Eliezer-Davidson/alpha-centauri/docs/evidence/chassis_pod_bolted.png

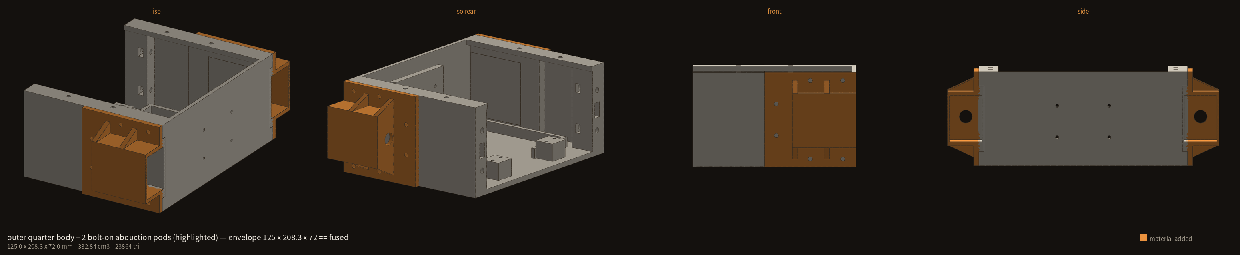
docs/evidence/chassis_pod_bolted.png
