Eliezer-Davidson/alpha-centauri/docs/evidence/chassis_pod_joint.png

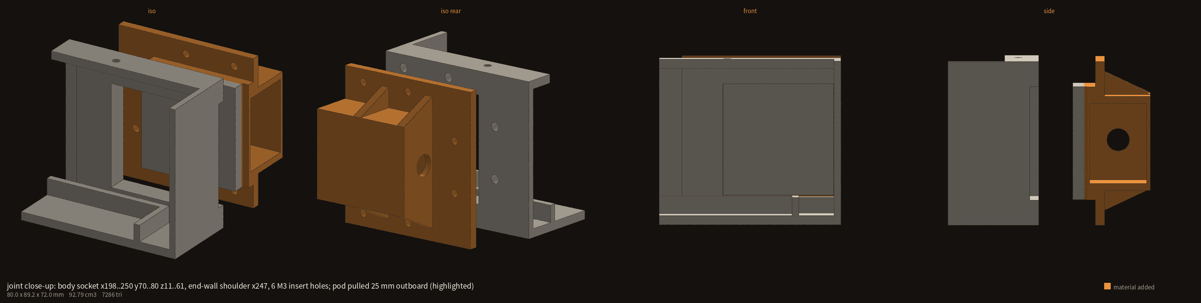
docs/evidence/chassis_pod_joint.png
