Eliezer-Davidson/alpha-centauri/docs/evidence/chassis_quarters_splice_key.png

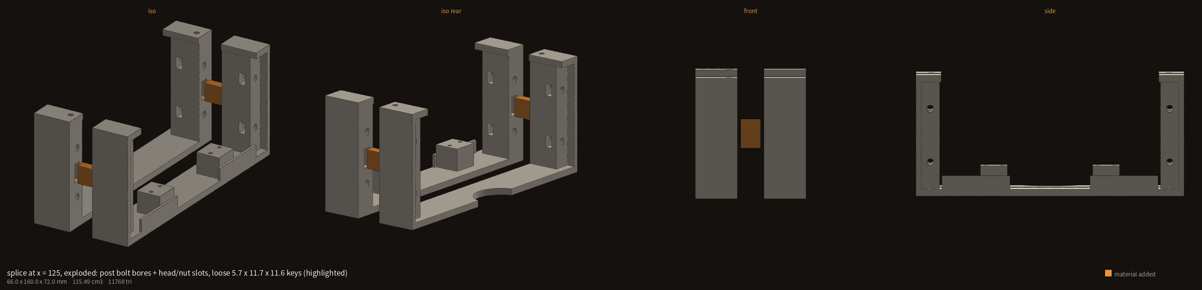
docs/evidence/chassis_quarters_splice_key.png
