Eliezer-Davidson/alpha-centauri/docs/evidence/dock_latch_engaged.png

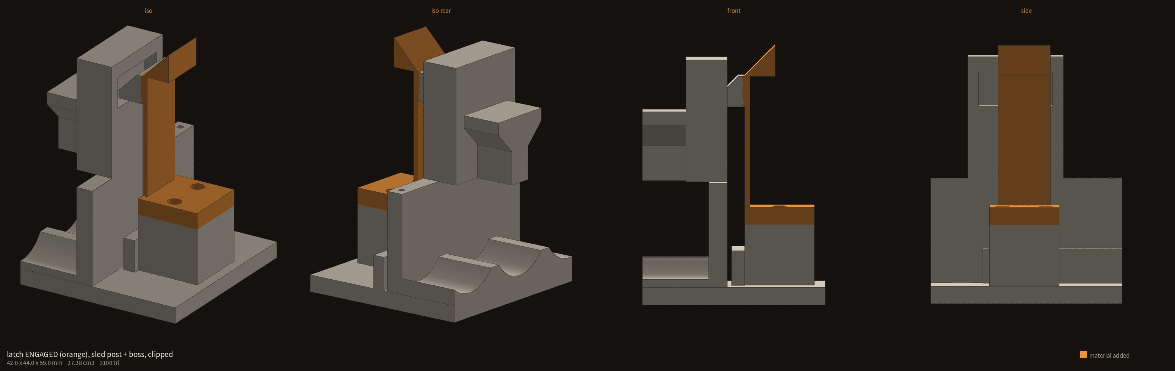
docs/evidence/dock_latch_engaged.png
