Eliezer-Davidson/alpha-centauri/docs/evidence/dock_robot_docked.png

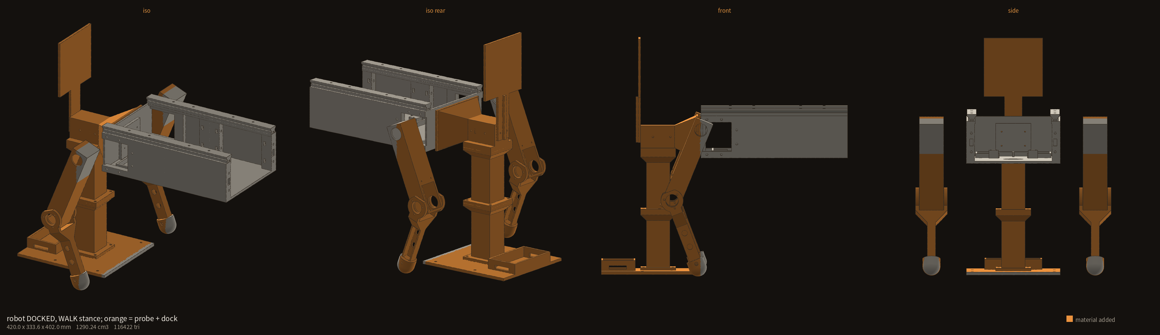
docs/evidence/dock_robot_docked.png
