Eliezer-Davidson/alpha-centauri/docs/evidence/foot_hero.png

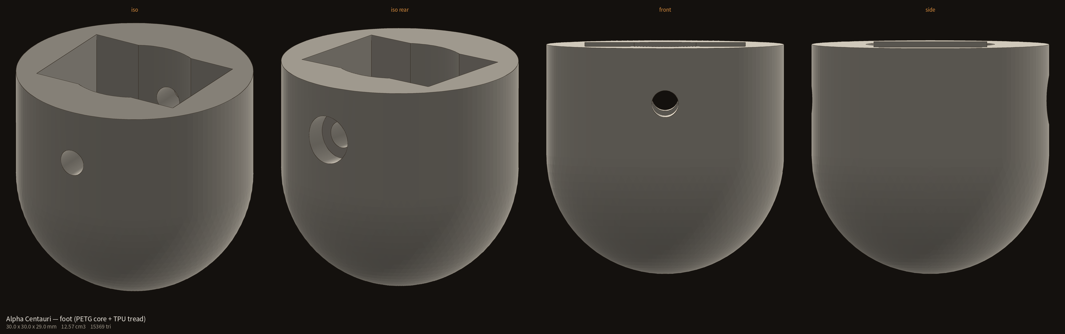
docs/evidence/foot_hero.png
