Eliezer-Davidson/alpha-centauri/docs/evidence/foot_on_calf_hero.png

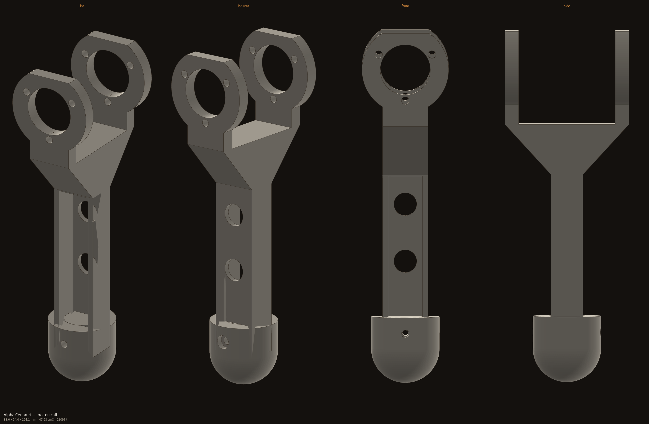
docs/evidence/foot_on_calf_hero.png
