Eliezer-Davidson/alpha-centauri/docs/evidence/foot_split_core.png

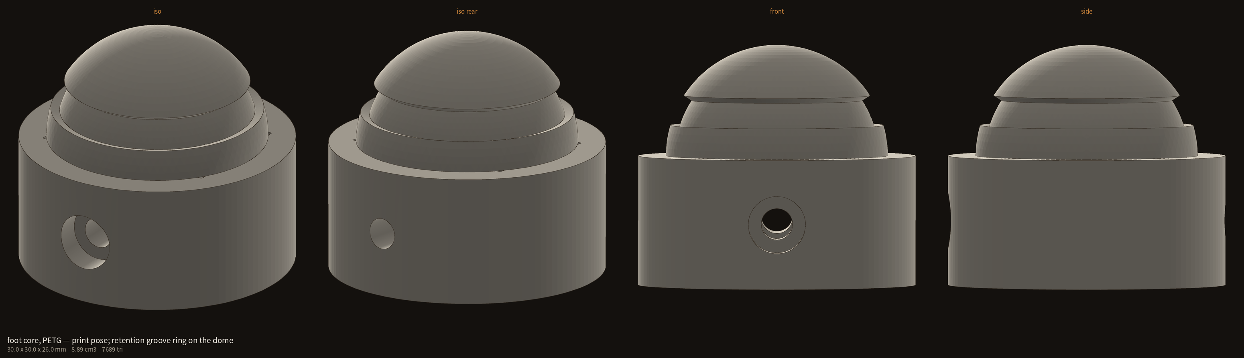
docs/evidence/foot_split_core.png
