Eliezer-Davidson/alpha-centauri/docs/evidence/foot_split_section.png

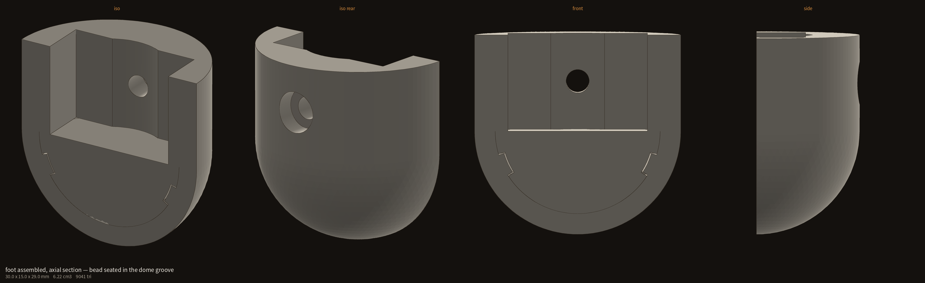
docs/evidence/foot_split_section.png
