Eliezer-Davidson/alpha-centauri/docs/evidence/foot_split_tread.png

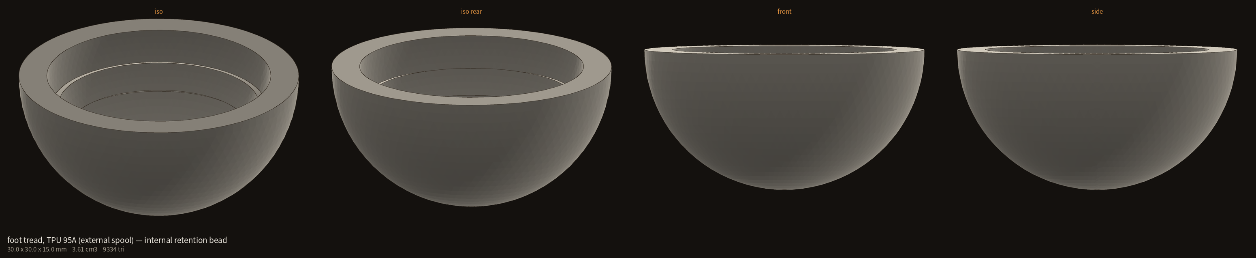
docs/evidence/foot_split_tread.png
