Eliezer-Davidson/alpha-centauri/docs/evidence/hip_leg_chain_hero.png

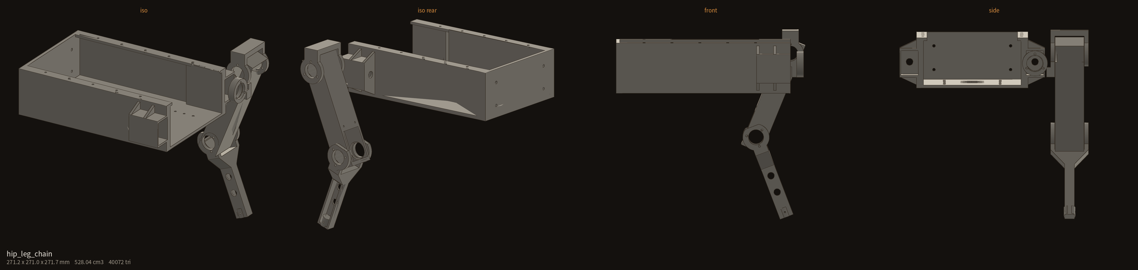
docs/evidence/hip_leg_chain_hero.png
