Eliezer-Davidson/alpha-centauri/docs/evidence/hip_module_hero.png

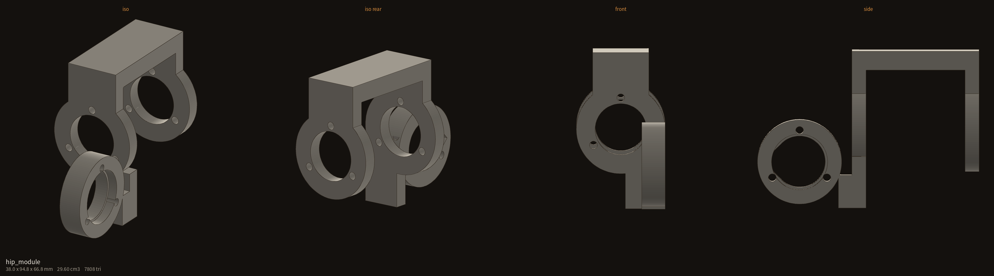
docs/evidence/hip_module_hero.png
