Eliezer-Davidson/alpha-centauri/docs/evidence/mk1_drive_closeup.png

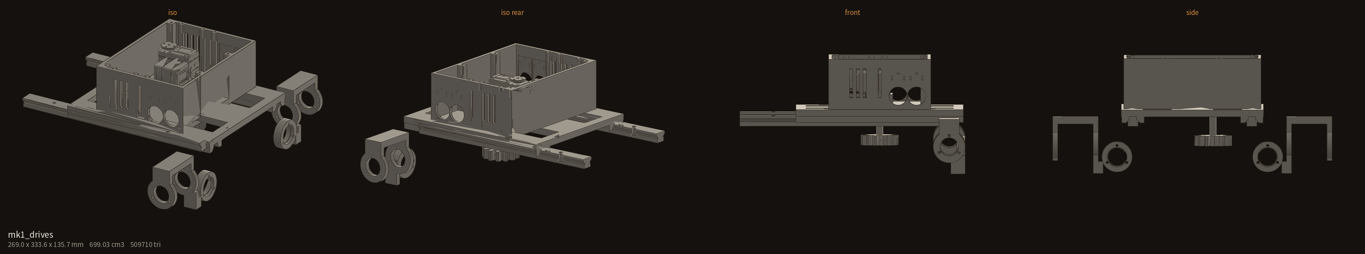
docs/evidence/mk1_drive_closeup.png
