Eliezer-Davidson/alpha-centauri/docs/evidence/mk1_work.png

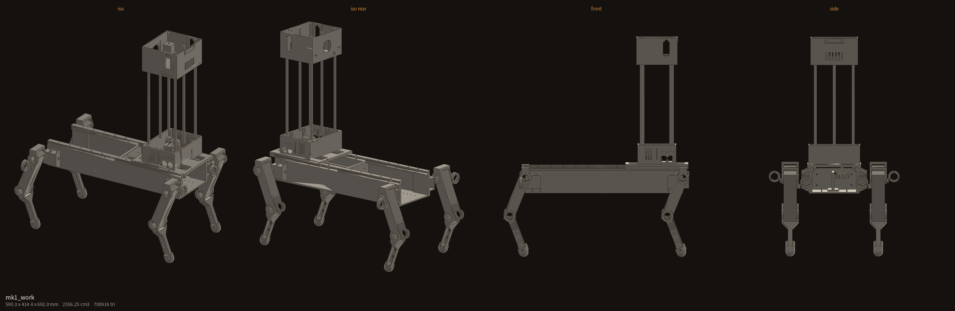
docs/evidence/mk1_work.png
