Eliezer-Davidson/alpha-centauri/docs/evidence/spine_rack_seam_engaged_hero.png

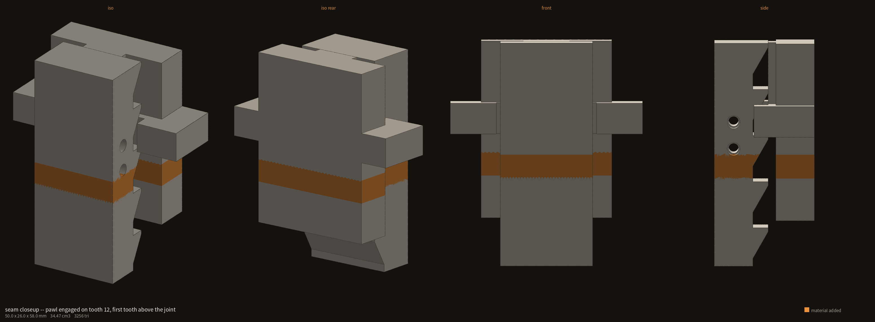
docs/evidence/spine_rack_seam_engaged_hero.png
