Eliezer-Davidson/alpha-centauri/docs/evidence/spine_rack_upper_hero.png

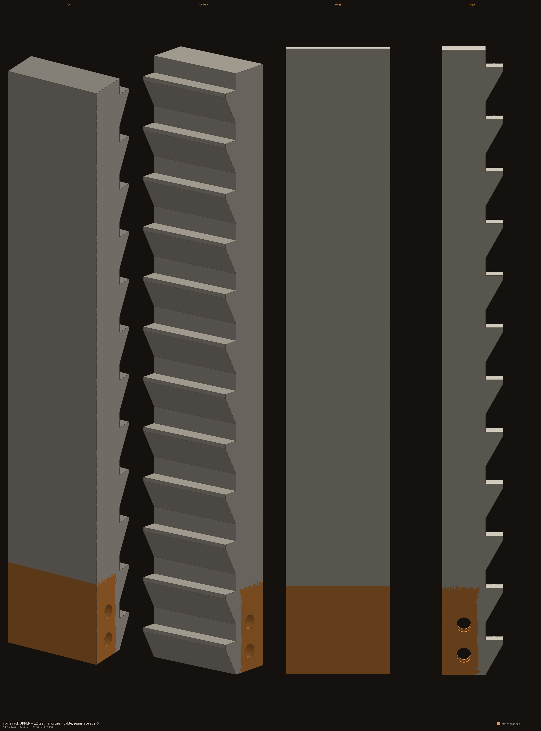
docs/evidence/spine_rack_upper_hero.png
