Eliezer-Davidson/alpha-centauri/docs/evidence/waist_rail_carriage_halves.png

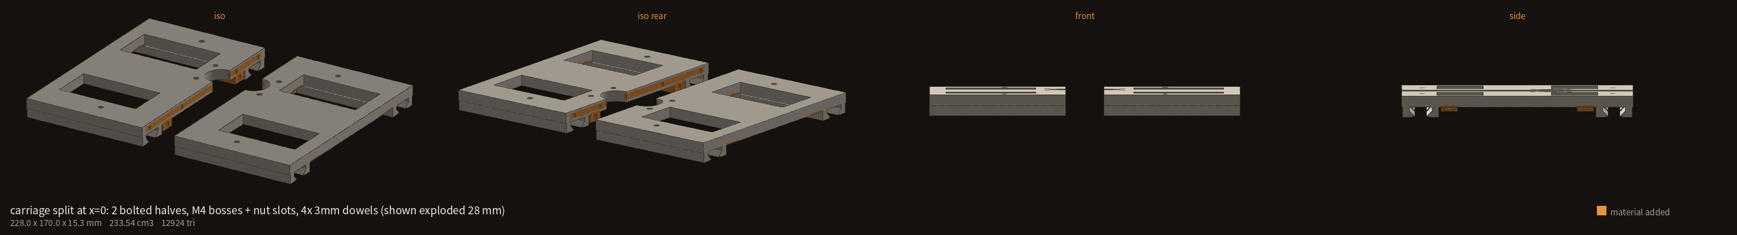
docs/evidence/waist_rail_carriage_halves.png
