Eliezer-Davidson/alpha-centauri/docs/evidence/waist_rail_joint_key.png

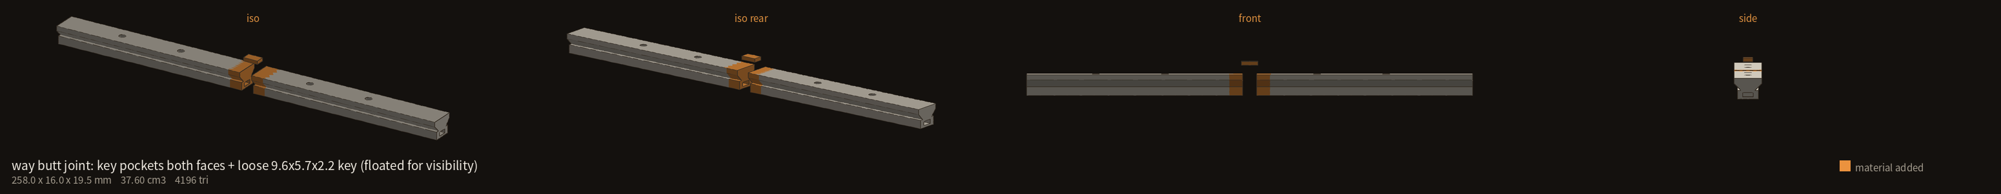
docs/evidence/waist_rail_joint_key.png
