Eliezer-Davidson/alpha-centauri/docs/evidence/waist_rail_segmented_ways.png

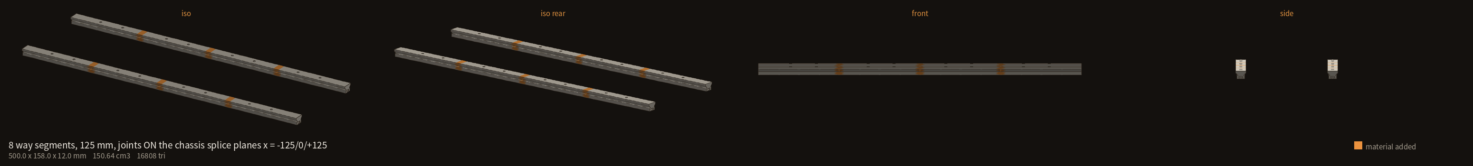
docs/evidence/waist_rail_segmented_ways.png
