Eliezer-Davidson/alpha-centauri/docs/evidence/dock_parts_print.png

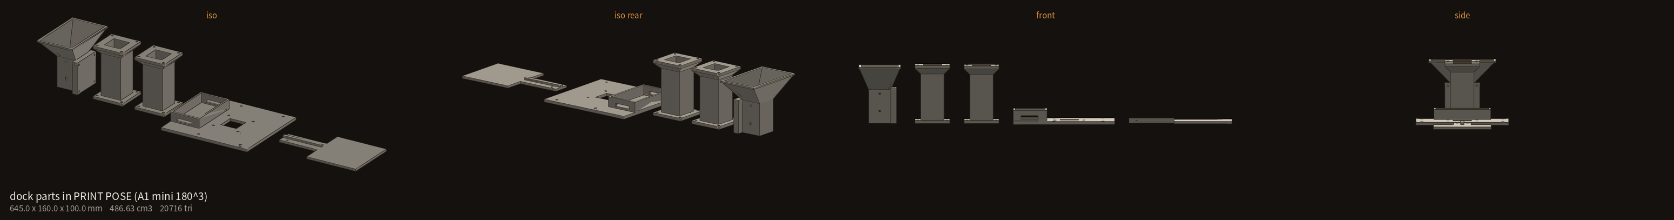
docs/evidence/dock_parts_print.png
