Eliezer-Davidson/alpha-centauri/edu/print_files_tall/RUN1/plate0_gauge/fit_gauge.stl

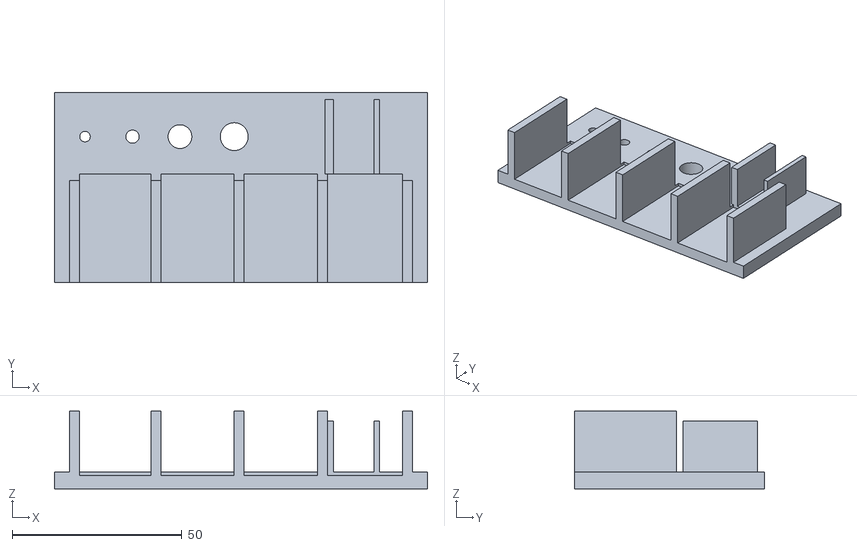
[picture p37: CAD file, 2026-10-18]
edu/print_files_tall/RUN1/plate0_gauge/fit_gauge.stl
110.0 x 56.0 x 23.0
