Eliezer-Davidson/alpha-centauri/edu/print_files_tall/step/mohawk_crest.step

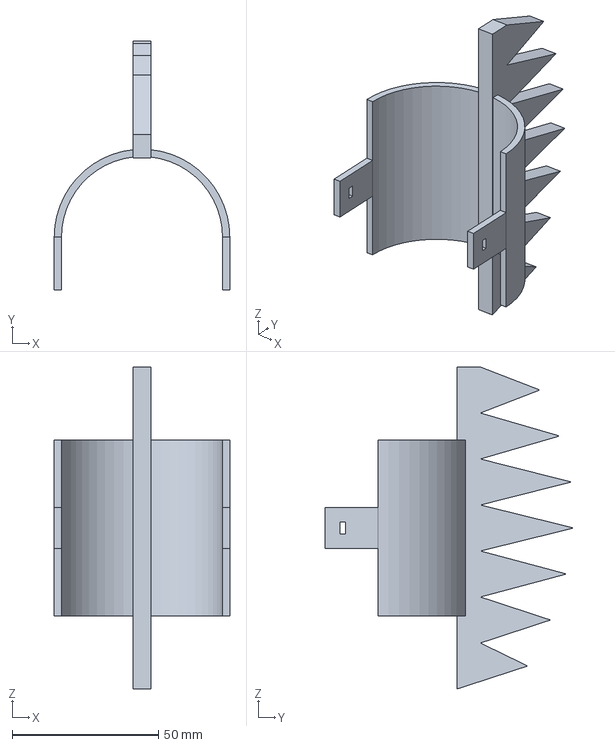
[picture p38: CAD file, 2026-10-18]
edu/print_files_tall/step/mohawk_crest.step
60.0 x 84.9 x 110.0 mm
