Eliezer-Davidson/alpha-centauri/(list of files, cad)

Other CAD files:
edu/print_files_tall/step/fit_gauge.step
edu/print_files_tall/stl/mohawk_crest.stl
