Eliezer-Davidson/alpha-centauri/docs/evidence/chassis_pod_print_pose.png

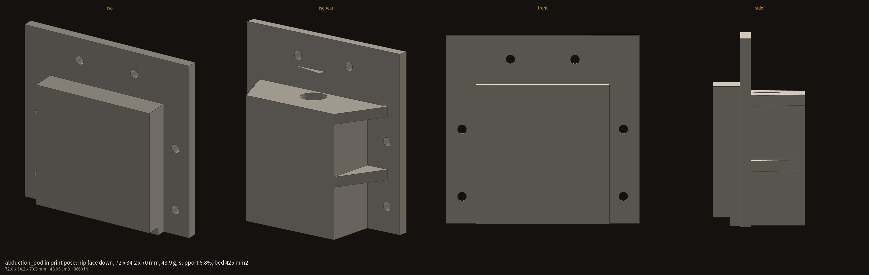
docs/evidence/chassis_pod_print_pose.png
