Eliezer-Davidson/alpha-centauri/docs/evidence/chassis_quarters_assembly.png

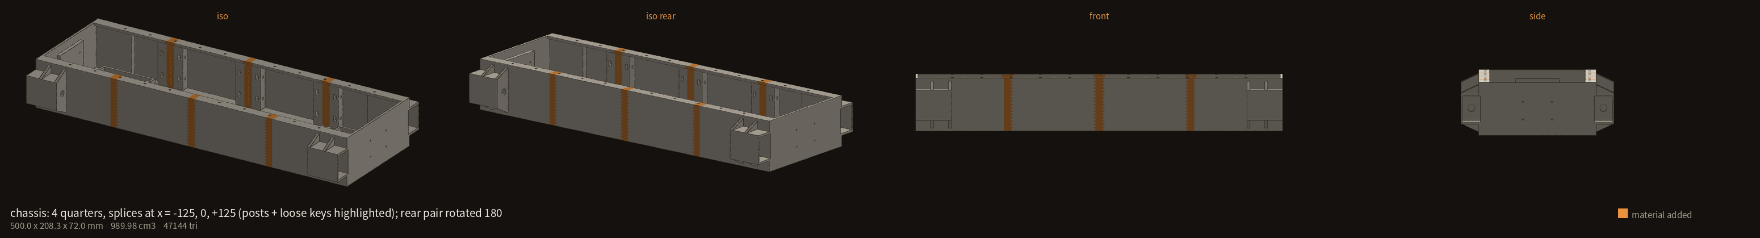
docs/evidence/chassis_quarters_assembly.png
