Eliezer-Davidson/alpha-centauri/edu/print_files_tall/renders/height_comparison.png

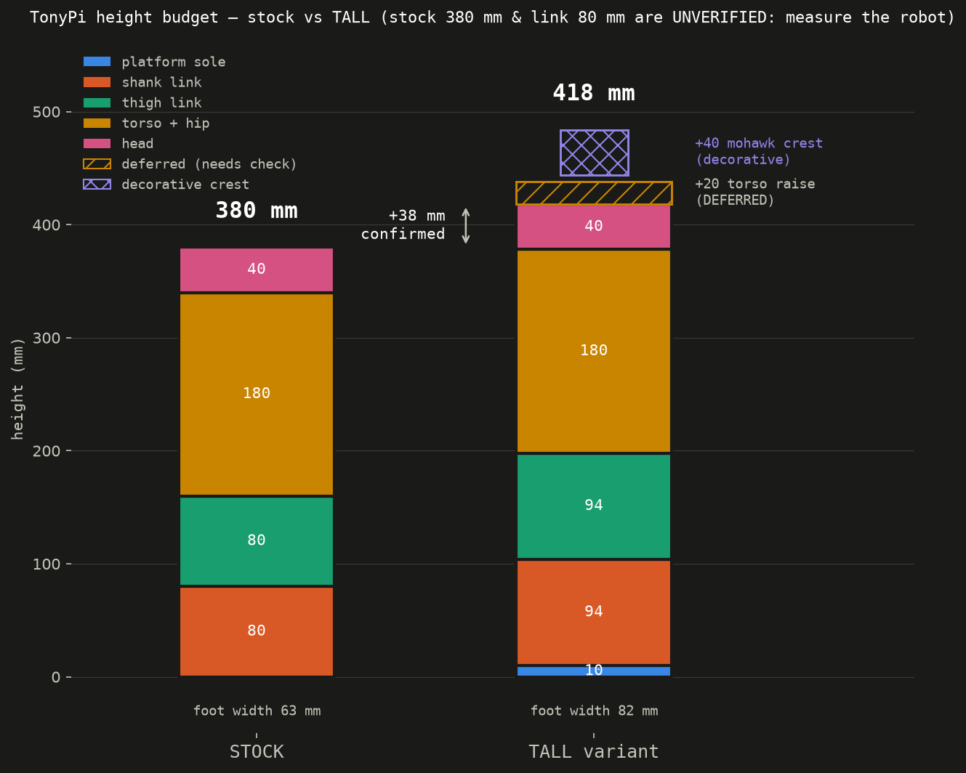
edu/print_files_tall/renders/height_comparison.png
