Eliezer-Davidson/alpha-centauri/edu/print_files_tall/renders/hero/fit_gauge_hero.png

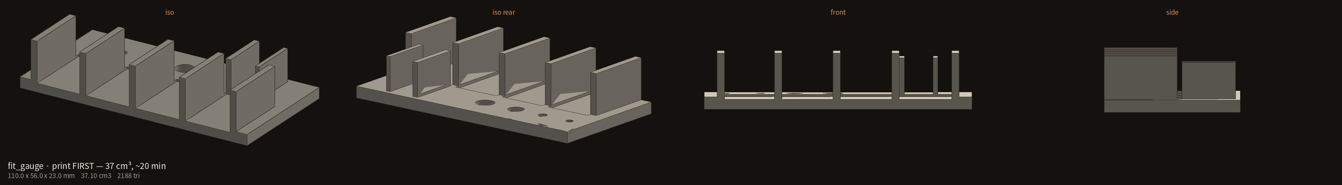
edu/print_files_tall/renders/hero/fit_gauge_hero.png
