Eliezer-Davidson/alpha-centauri/edu/print_files_tall/renders/hero/mohawk_crest_hero.png

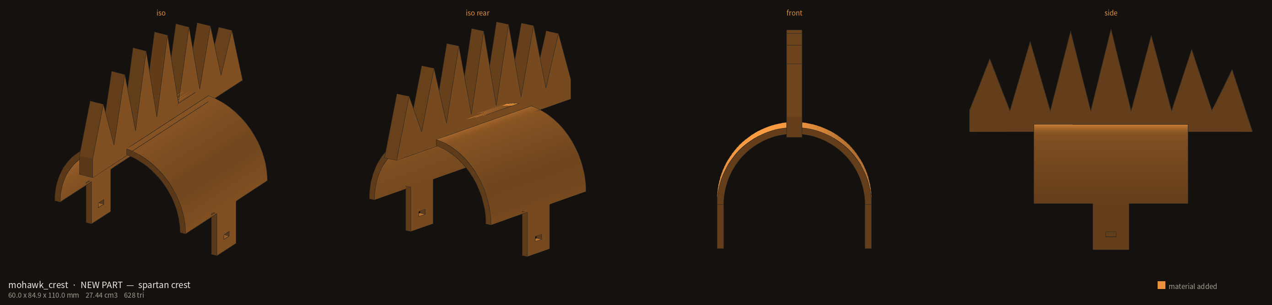
edu/print_files_tall/renders/hero/mohawk_crest_hero.png
