Eliezer-Davidson/alpha-centauri/cad/telescopebot/VERIFICATION.md

# TelescopeBot CAD — adversarial verification report (2026-07-30)

Pipeline: datasheet research -> `hardware_constants.py` (12 components, 54
UNVERIFIED constants needing calipers) -> authoring (waist_box.py, chest_box.py,
leg_linkage.py) -> three independent verification passes that re-ran every script
and measured the B-rep (wall census, boolean interference, facet-normal overhang
audit). The verdicts below are those passes'; fixes applied afterwards are marked
FIXED.

## waist_box (waist_box.py -> waist_box.stl + spine_servo_deck.stl)
**Verdict: PASS_WITH_ISSUES**

### Issues
- MAJOR: ST3215 retention screws mis-specified vs hardware_constants — code drills four 2.4 mm ('M2') floor holes up into the boss's 9.9-square pattern, but ST3215_TOP_HOLE_DIA=2.5 (M3 tap-drill, blind 2.5) and ST3215_HORN_SCREW_M=3: an M2 screw cannot engage a 2.5 mm hole and an M3 cannot pass a 2.4 mm hole. As printed the waist-yaw servo cannot be screwed down; holes should be M3_CLEAR (3.4). Field fix is drilling the 1.5 mm web, but the assumption list presents this as clean.
- MAJOR: the required width-choice statement's rationale is contradicted by the sibling part — chest_box.py (same directory, authored first) has BOX_DEPTH=130.0 > the waist's 114 mm interior depth (assumption claimed chest depth <= ~108), and the chest rod line sits at its REAR (ROD_Y=-49.5) while the waist shafts are at waist center y=0, so the aligned chest spans waist y -15.5..+114.5 and can never descend into the mouth in Y regardless of the 156 mm width. No functional impact today (chest bottoms out on the 34 mm horn-coupler tops above the rim, as the docstring itself admits), but the 'telescopes OVER the chest' story does not hold against the chest as designed.
- MAJOR: disclosed requirement deviation on hip DOF — the brief asked per-leg pitch+roll SCS15 bays at the bottom corners; all four bays have shafts along +/-X (two PARALLEL pitch-type axes per leg), roll deferred to an unbuilt external bracket, and bays moved to the FRONT corners. The rear-corner impossibility is real (verified: a side-wall SCS15 body envelope x 37.4..78 overlaps the battery envelope x +/-55.5, y -57..-16.5), but this changes the robot's DOF plan and needs the author's sign-off.
- MINOR: SCS15 idler-boss vs front lid posts — with a 12 mm boss dia (dimension ABSENT from hardware_constants; only 5.6 protrusion recorded) the inboard idler boss of both y=44 bays intersects the (+/-32, 53) lid posts by 18.9 mm^3 (~1 mm sliver); clears if boss dia <= 10 mm. Caliper the boss; if 12, nudge posts or clip a corner. Not covered by any module assert.
- MINOR: hanging spine-servo front face (y=10.03) to y=22 hip-bay recess edge (y=11.65) is only 1.63 mm; asserted positive but leaves no allowance for FS5103R case-lid screw heads/label bulge.
- MINOR: deck ligaments below the 3 mm wall rule — 2.73 mm between flange-bolt M3 hole edge and cutout end, 2.30 mm from rim-screw hole edge to deck edge (bolt-tension loaded; use washers).
- MINOR: floor web under the ST3215 boss is 1.5 mm (< WALL_MM 3.0); documented as retention-only with pocket walls taking yaw torque — acceptable draft deviation but it is a sub-minimum structural member.
- MINOR: claim inaccuracies — '10 asserts at module scope' is actually 9 module-scope + 1 in the deck function; the claimed '~4 mm annular ring bridge over the ST3215 pass-through' does not exist (that annulus is upward-facing; error in the safe direction); the near-center M2 hole is NOT fully absorbed by the horn window (10.0+1.2 > 11.0 — a 0.2 mm crescent notch survives on the window rim, cosmetic; '5 effective screws' still correct); proof PNG (16:33) predates the final STL exports (16:34) by one minute, benign since geometry is deterministic and re-verified identical.

### Author assumptions (all pending caliper verification)
- Chest box external width taken as exactly 150.0 mm (task said ~150); chest external depth assumed <= ~108 mm so it clears the 114 mm interior depth.
- Width choice (stated in docstring): waist telescopes OVER the chest -- interior width 156 = 150 + 3 mm/side so the chest descends into the open mouth. Chest-outside-waist is geometrically impossible at 120 mm rod spacing: it caps interior half-width at ~68 mm but an FS5103R body centered 10.05 mm outboard of a shaft at x=60 reaches x=70.4.
- Architectural dims not in hardware_constants: walls 4.0, floor 4.0, rim height 60.0, interior 156 x 114, outer 164 x 122 x 60.
- Spine servo deck is a SEPARATE bolt-on part (164 x 68 x 5): an integrated mid-height shelf would be a ~156 mm unsupported bridge, unprintable support-free. Deck seats on the side-wall rims; mount plane z=65; six M3 self-tappers into 12 mm rim pilots backed by full-height 4 mm internal ribs.
- FS5103R orientation: long axis along Y, shaft toward +Y, both servos identical; shaft axes at (+/-60, 0) exactly SPINE_ROD_SPACING_MM apart. Flange bolts are M3 + nut through M3_CLEAR holes at the researched 49.5 x 10.0 pattern (servo holes are 4.5 dia).
- Coupler clearance: a 32 dia x 48 tall column above each flange is open sky (28 dia x 34 coupler + margin); verified by assert, servos hang 25.9 below deck top to z=39.1, clearing battery top (34) by 5.1 mm.
- M2 clearance hole dia 2.4 (house constants only define the 1.8 pilot).
- SCS15 horn window 22.0 dia = ROUND_HORN_DIA 19.95 + 2.05 clearance.
- Hip bays deviate from 'bottom corners' deliberately: all four SCS15 bays are on the side walls, body vertical, bottom face 2 mm above the floor, shaft axes at z=16.15 pointing out +/-X, paired toward the FRONT corners (y=+22 and +44) because the 110 x 40 battery tray owns the rear floor -- a rear-corner pocket cannot coexist with it in a 156 mm interior. Per-leg roll DOF hangs off an external bracket in a later part. Bay = 0.6 mm locating recess (0.5 fit) + horn window + M2 clearance holes at the researched SCS15 top-face pattern.
- ST3215 waist yaw: pocket fit 0.5, pad walls 3.0, capture depth 12; boss recess = BOSS_DIA + 0.5 x 2.5 deep; spline/horn-hub pass-through 12.0 dia (assumed); M2 screws come up from below through 2.4 holes -- only ~1.5 mm of floor remains under the boss (retention only, pocket walls take the yaw torque).
- Battery tray: 0.5 mm clearance per side, retaining ribs 3 thick x 10 tall; interior depth was bumped 110 -> 114 specifically so the battery envelope clears the ST3215 pad (0.85 mm margin, asserted). Battery envelope itself is UNVERIFIED in hardware_constants -- caliper before printing.
- Vent slots 4 x 35 mm, four per side wall, bottom edge at z=14.
- Lid posts 8 x 8 full-height at (+/-32, +53) and (+/-74, -53) with M3 pilots 12 deep; front pair sits inboard of the hip bays.

### Verification measurements
- Re-run: exports regenerated (waist_box.stl/.step, spine_servo_deck.stl/.step, new mtimes), printed output identical to claim: waist_box 164.0 x 122.0 x 60.0 mm / 221.3 cm^3; deck 164.0 x 68.0 x 5.0 mm / 46.7 cm^3 — both far inside the 350 mm bed.
- Spine shaft spacing measured from deck cutout centers: -60.000 / +60.000 -> 120.000 mm, exactly SPINE_ROD_SPACING_MM and symmetric; deck rim-screw holes (+/-78, -40/-10/6) coincide exactly with the box rim pilots.
- Walls (BRep plane census): side walls 82-78 = 4.00; at hip recess 82-78.6 = 3.40; front/rear 61-57 = 4.00; floor 4.00; ST pad walls 25.95-22.95 = 3.00 (X) and 15.65-12.65 = 3.00 (Y); battery ribs 3.00; deck ribs 4.00; deck plate 5.00 — all >= 3 mm except the documented 1.5 mm boss web and the two deck ligaments (2.73 / 2.30 mm) flagged above.
- Pocket clearances vs hardware_constants (all positive, 0.5 total unless noted): deck flange cutouts 20.65 x 40.65 vs body 20.15 x 40.15 (+0.5); flange M3_CLEAR r=1.70 holes at exact 49.5 x 10.0 pattern (y=-34.8/14.7, x=+/-55/65); ST3215 pocket 45.9 x 25.3 vs 45.4 x 24.8 (+0.5), boss recess dia 20.5 vs 20.0 (+0.5) x 2.5 deep, ST M2 holes at exact +/-4.95 (9.9 square); hip recesses 20.7 x 40.7 vs 20.2 x 40.2 (+0.5) x 0.6 deep, horn windows r=11.00 at exact axis height z=16.15, y=22/44; battery rib faces +/-55.5 and -16.5 give +0.5/side around the 110 x 40 envelope; 10 M3_PILOT r=1.35 holes at all 6 rim + 4 post positions.
- Interference booleans (intersection volume): FS5103R hanging bodies, battery envelope, ST3215 body+boss, all four SCS15 bodies, both 32-dia x 48 coupler columns (vs box AND deck), and deck-seated-on-rim vs box ALL = 0.000 mm^3; only SCS15 12-dia idler boss vs front lid posts = 18.907 mm^3 per side at y=44.
- Derived margins: spine body |x| 70.325 vs rib face 74.0 (3.68); spine bottom z=39.10 vs battery top 34.0 (5.10, matches claimed 5.1); ST pad edge 15.65 vs battery envelope front 16.5 (0.85, matches claim); spine front y=10.025 vs hip bay edge 11.65 (1.63).
- Printability (own STL facet audit, overhang = asin(-nz) > 50 deg, bed face excluded): waist_box 5.02 cm^2 TOTAL across 36 regions but largest single region 52.6 mm^2 = 0.53 cm^2 (horn-window top arcs x4), then 8 flat 16 mm^2 vent-slot ceilings (4 mm bridges) and 12.4 mm^2 recess tops — ZERO regions > 2 cm^2; spine_servo_deck 0.00 cm^2. Both parts print support-free as exported.
- Assumption cross-checks: chest_box.py BOX_WIDTH = 150.0 exactly (waist assumption TRUE) but BOX_DEPTH = 130.0 and ROD_Y = -49.5 (waist depth assumption FALSE, see MAJOR); FS5103R 49.5/10.0/4.5/25.9/10.05, SCS15 19.95 horn + full top-face hole pattern, ST3215 45.4/24.8/20.0/2.5/9.9 all correctly transcribed from hardware_constants; M2_CLEAR=2.4 sane for true M2 hardware (hip bays OK — servo pilots are 1.6 for M2) but wrong for the ST3215 boss (M3-class); proof PNG exists and depicts both labeled parts.

## chest_box (TelescopeBot moving carriage) — `cad/telescopebot/chest_box.py` -> `output/chest_box.{stl,step}`
**Verdict: PASS_WITH_ISSUES**

### Issues
- CRITICAL (by the task's >2 cm^2 aggregate threshold; see nuance): shoulder-pad undersides at z=17 are blind 90-deg ledges — flat horizontal undersides 3.0 mm deep x 36 mm, anchored only along the wall, 1.08 cm^2 each, 2.16 cm^2 combined. Not bridges (free at both ends). No SINGLE region exceeds 2 cm^2, droop is cosmetic (pocket bottom is 12.3 mm higher, pilots 8.9 mm higher), and PETG will droop-print rather than fail — hence overall verdict PASS_WITH_ISSUES, not FAIL. Fix is one house-style 45-deg under-chamfer per pad; the author applied exactly this treatment to the RealSense strip in the same part but missed the pads.
- MINOR: RealSense screw stack is designed to exactly Intel's 3.0 mm max insertion (3.0 wall + 2.0 boss = 5.0; M3x8 -> 3.0, asserted in code). Zero margin: a wall printed 0.1-0.2 mm thin pushes insertion past spec and the screws bottom out in the camera. Add one washer per screw or verify printed wall thickness first.
- MINOR: LM2596 pilot depth is 6.0 mm (z 8.0 -> 2.0) with only 2.0 mm floor beneath; an M3x8 through the 1.6 mm board needs 6.4 mm — bottoms out 0.4 mm before seating. Use M3x6 (4.4 mm engagement). No screw length is specified anywhere for this bay.
- MINOR: hardware_constants explicitly says MG996R mounts should be DESIGNED WITH SLOTTED HOLES (4.3 x 6) due to clone spacing variance 48.0-48.6 / 10.0-10.4; the part uses round 2.7 mm self-tap pilots at exact nominal 48.30 x 10.20. Variance must be absorbed by the flange-hole slack (4.2 hole vs 3.0 screw, ~±0.6) — workable with the claimed washers, but it contradicts the constants' stated recommendation. MEASURE-BEFORE-TRUSTING caveat was correctly carried by the author.
- MINOR (documented deviation, correct call): Jetson standoffs use 2.2 mm pilots for M2.5, deviating from the original requirement's 'M3 pilots' — consistent with hardware_constants (ORIN_NANO_HOLE_DIA=2.75, 'M3 will NOT pass'). The requirement as written is physically unsatisfiable; deviation is explicit in the code comments and the author's claims.
- MINOR: web between each fan pilot and the octagon opening edge measures 2.17 mm (< WALL_MM 3.0). Non-structural and inherent to the standard 40 mm fan pattern (a round 38.2 opening gives the same 2.18 mm), but self-tapping M3 into a 2.7 pilot 2.2 mm from a free edge can split; drive gently or use M3_CLEAR + nuts (constants allow either).

### Author assumptions (all pending caliper verification)
- Box envelope 150 x 130 x 85 mm external with 4 mm floor -- architectural choices (width per task's ~150; depth sized so the Jetson mounted length-along-Y and the LM2596 bay coexist; height clears the gabled shoulder pockets)
- Rod clearance bore 8.5 mm dia -- task-specified, not present in hardware_constants.py
- Nut towers: 29 x 31 x 48 mm blocks fused into the rear wall and side walls; bore axis 14 mm from the tower inboard face; nut slot bottom at Z=20; slot ends 0.5 mm past the nut half-diagonal (M8_NUT_AF/sqrt(3)) so the nut centers on the bore
- Jetson standoff pilots are 2.2 mm for M2.5 self-tappers -- a DELIBERATE deviation from the task's 'M3 pilots': ORIN_NANO_HOLE_DIA=2.75 and the researched constants state M3 will NOT pass the devkit holes. Boss height 6.0 (ORIN_NANO_BOSS_HEIGHT_MIN+1), boss OD = official 8.0 keep-out, pattern center at X=+2 with board length along Y and the I/O edge facing -X (28 mm connector clearance to the left wall)
- RealSense D435/D435i selected (M3 rear holes at 45 mm; the D455 uses M4 and would need a constants edit): hole height Z=77 puts the camera top ~4.5 mm above the box rim for clear FOV; boss row 2 mm proud, 60 long, 12 tall, 45-deg chamfered underside; total screw stack 5.0 mm so M3x8 gives exactly the 3.0 mm max insertion (asserted in code)
- MG996R shoulder pockets: 0.5 mm clearance per side around the body; centers at (Y=30, Z=50) chosen to clear the towers, nut slots, Jetson I/O connectors, and LM2596 components; pilots M3_PILOT for M3 self-tappers + washers (constants recommend washers due to 4.0-4.3 clone hole variance); interior pads thicken the wall 3->6 mm for screw engagement; 45-deg gable roofs replace 41 mm bridges
- Fan opening is an OCTAGON (apothem = FAN40_OPENING_DIA/2 = 19.1) instead of a round hole so the vertical rear wall prints support-free (45-deg diagonals, 15.8 mm flat top bridge); fan center Z=42; wall pilots M3_PILOT
- Grommet 10 mm dia (task-given) at (X=+35, Z=12); left ROUND -- a rubber grommet needs a circular hole and a <=10 mm circular bridge in a vertical wall prints acceptably (the one knowing exception to the 50-deg overhang rule)
- Ventilation: 6 front-wall slots 4 x 25 mm at 10 mm pitch (4 mm top bridges)
- LM2596 bay center (56, 25): bosses OD 7 x 4 tall at the two diagonal corner holes (spacing from LM2596_HOLE_SPACING_DX/DY); pilots M3_PILOT for M3 self-tap through the board's 3.0 mm holes (clones vary -- caliper first per constants); rails 3 mm thick with 0.2 mm per-side clearance, ends open for wiring, trimpot faces the open top
- Modeling robustness values: 0.5 mm solid embed where added bosses meet walls/floor and 0.5 mm cutter overshoot past faces (no coincident-face booleans)

### Verification measurements
- Re-run: exports regenerated (stl+step mtime 1785408438 -> 1785409136); console '150.0 x 132.0 x 85.0 mm, volume 268.3 cm^3'; independent re-import: 1 solid, 268.25 cm^3, bbox 150.000 x 132.000 x 85.000 (Y=132 = 130 box + 2 proud RealSense boss row, as claimed)
- Bed fit: 150.0 x 132.0 x 85.0 vs 350^3 bed -> margins 200.0 / 218.0 / 265.0 mm
- Spine spacing: rod bore axes measured at X = -60.000 / +60.000 -> 120.000 mm = SPINE_ROD_SPACING_MM exactly; bore r=4.25 (dia 8.5, task-specified) vertical through tower+floor (z -0.5..48.5) -> 0.25 mm/side radial vs 8.0 rod (sane slide fit)
- Wall thickness scans (all >= 3.0 rule): side wall 3.00 (two locations), rear wall 3.00, front wall 3.00, floor 4.00, side wall+shoulder pad 6.00 (both sides), tower bore ligaments 9.74 (inboard) / 10.74 (outboard), tower depth 30.99; grommet-to-floor ligament 3.00 (exactly at minimum, not below)
- Captive nut slot: width 13.40 (X 53.30..66.70, straddling bore at 60) vs ISO M8 nut AF 13.0 -> 0.20/side; height 7.00 (z 20..27) vs ISO 4032 nut 6.8 max -> 0.20; slot end y=-41.264 -> nut-corner axial margin 0.73 mm past centered position; slot confirmed open through rear wall (air from y=-65 to -41.26); rod through nut traps translation+rotation as claimed
- Shoulder pockets: opening 21.00 (Y 19.50..40.50) x 41.3 (Z 29.34..70.65) + gable to peak ~81.15 (measured between probes 81.0/81.4) vs MG996R body 20.0 x 40.3 -> 0.50/side; pilot pattern measured 10.20 x 48.30 = MG996R_HOLE_SPACING_WIDTH/LENGTH; 8 pilots r=1.35 through 6.00 mm wall+pad
- Jetson: 4 pilots r=1.10 (dia 2.2) at spans dX=58.00 / dY=86.00 = ORIN_NANO_HOLE_SPACING_Y/X; bosses r=4.00 (OD 8.0 = keep-out max), boss top z=10 -> 6.0 above floor (>= BOSS_HEIGHT_MIN 5.0); pilot bottoms z=2.0 -> 2 mm floor left, 8.0 mm engagement; pattern center X=+2 -> I/O edge at x=-44, 28.0 mm to left wall interior (x=-72); board footprint clash-probed all air
- LM2596: bosses r=3.5 at (48.0,10.02)/(64.0,39.98) -> diagonal 16.00 x 29.96 vs constants 16.0 x 29.97 (0.01 tessellation); rails 3.0 thick, 0.2/side clearance, top z=12.00, ends open; pilots r=1.35 to z=2.0
- RealSense: 2 holes r=1.70 (dia 3.4 = M3_CLEAR) at spacing 45.00 = D435_REAR_M3_SPACING, z=77.0; strip face y=67.0 (2.0 proud), strip z 71..83, 45-deg underside chamfer verified in STL; camera top = 77+12.5 = 89.5 -> 4.5 above the 85 rim as claimed; stack 5.0 + 3.0 = 8.0 asserted in code
- Fan: octagon apothem 19.1 (opening z 23.0..61.0 sampled ~ 22.9..61.1 flat-to-flat = 38.2 = FAN40_OPENING_DIA), flats-up orientation CONFIRMED (top width ~16.0 ~ 15.8 flat + 45-deg diagonals); 4 pilots r=1.35 at 32.0 x 32.0 = FAN40_HOLE_SPACING; constants explicitly permit M3_PILOT self-taps; pilot-to-opening web 2.17 mm
- Grommet: r=5.00 (dia 10, task-specified) at (35, z=12) in rear wall; vents: 6 slots, 6 mm webs, 4 mm top bridges (z 15..40)
- Overhang audit (13,940 facets): strict >50-deg-from-vertical off-bed area 9.70 cm^2, fully attributed with zero unexplained residual: 5.23 nut-slot ceiling bridges (13.4 mm span, anchored both sides full length), 0.72 vent-top bridges (4 mm), 0.48 octagon flat bridge (15.8 mm), 0.91 horizontal hole arcs (dia 2.7-3.4, self-supporting), 0.21 grommet arc (the documented exception), 2.16 blind shoulder-pad ledges (the only true violation); 6.15 cm^2 of downward faces sit at exactly 45.0 deg (gables, octagon diagonals, strip chamfer) — at the design limit, compliant with <=50
- Clash probes all air: Jetson board corners/(-58,0,15) I/O room, LM board space, camera space above rim, servo body inboard end (50,30,50), rod line above tower (60,-49.5,60)
- Author-claim audit: bbox/volume/1-solid/STEP-export/flats-up-octagon/45-deg-only-chamfers/bridge-inventory all independently confirmed; no contradiction between the assumptions list and hardware_constants.py found; the two deliberate deviations (M2.5 pilots, octagonal fan opening) are justified by constants and print rules respectively

## leg_linkage.py (thigh_link + calf_link)
**Verdict: PASS_WITH_ISSUES**

### Issues
- MAJOR: hip disc ligament between the 10.0 dia center-clearance bore and each of the 4x M3 clearance holes (3.4 on PCD 14) measures 0.30 mm — below one 0.4 mm extrusion width, so it prints as 4 ragged slivers or merges the holes into a rosette; M3 pan heads (~5.7-6 dia) at PCD 14 also overhang the center bore by ~1 mm. Both PCD and hub-clear are ASSUMED values, so fix when the real SCS15 horn is measured (larger PCD or smaller hub clearance) and use washers regardless.
- MAJOR: pilot-boss ligaments in load paths violate the >= 3 mm structural-wall rule: thigh M4 pilot -> lightening/wire notch 2.21 mm (all 4 pilots), rear pilot -> DS cavity 2.61 mm, front pilot -> DS cavity 2.81 mm; calf MG996R pilot -> servo cavity 2.02 mm (rear) / 2.32 mm (front). Self-tapping expansion thins these further; these columns carry the knee-servo and ankle-servo reactions. Narrowing NOTCH_HALF_W and shrinking the block-to-cavity trim margins would recover >= 3 mm without moving the fixed hole patterns.
- MINOR: thigh horizontal tendon posts — the 45-deg under-wedge does not remove the cylinder's own >50-deg under-band; measured 0.32 cm^2 of flagged area per post (clusters 20.2 + 6.6 + 5.1 mm^2, up to 90 deg). Wedge-backed at tangency so sag is bounded and area is far under 2 cm^2, but it is not strictly support-free geometry; a teardrop post profile would be. The wedge/post tangency also creates 4 four-facet seam edges in the STL (valid solid, slicer-safe).
- MINOR: calf total off-bed >50-deg overhang is 1.99 cm^2 — passes the 2 cm^2 bar by 0.014 cm^2. Largest contributors: the two lug round tips resting tangent on the bed (37.4 mm^2 each, max 77 deg, 'wheel on bed' geometry that prints rough in the first mm) and nine small horizontal-hole ceilings (11.9-16.2 mm^2 each, dia 2.7-3.4 — self-supporting at this size in practice).
- MINOR: MG996R mounting contradicts hardware_constants.py's own guidance 'DESIGN WITH SLOTTED HOLES (4.3 x 6 slots) and M3/M4 screws with washers' — fixed round 2.7 self-tap pilots at the nominal 48.3 x 10.2 centers were used instead; clone spread (48.0-48.6 x 10.0-10.4) can misplace pilots by +/-0.3 mm. Mitigated by the prominent caliper-before-printing warnings, but it is a real assumption-vs-constants contradiction.
- MINOR: documented spec deviations — task asked 'M3/M4 clearance holes per its flange' for the DS5160; author substituted M4 self-tap pilots (justification checks out: nuts cannot be loaded under 39-mm-deep columns, and DS5160_HOLE_DIA 5.5 passes M4). Calf tendon posts claimed 'near ankle': x=104.5 is, but x=55 is mid-calf (35 mm from the ankle axis), placed there to anchor on the flange block.
- MINOR: hardware_constants.py is internally inconsistent by 0.2 mm for the DS5160 (body 65.0 + 2 x 5.1 hole-beyond-face = 75.2 != 75.0 hole span); absorbed by the 0.5 mm pocket clearance, but it is unresolvable until calipered. Also the claimed 'MG996R pocket 0.25 mm per side across the body width' is only literally true of the floor strips at z=4.75; the pocket top is open and most of the under-servo floor is the 4.0 web (1.0 mm clearance) — imprecise wording, harmless geometry.

### Author assumptions (all pending caliper verification)
- DS5160 flange fastening: M4 self-tappers into 3.6 mm pilots (M4 pilot extrapolated as 0.9*d from the house M2/M3 pilot rule), 12 mm deep. The brief specified 'M3/M4 clearance holes per its flange'; true clearance holes would need nuts under 39 mm deep columns, which cannot be loaded or printed support-free, so self-tap was chosen -- the DS5160's own 5.5 mm flange holes pass M4 hardware. Sweep M4_PILOT to 4.5 if bolts+heat-sets are preferred.
- Servo pocket clearance 0.5 mm per side (mirrors FS5103R_POCKET_CLEARANCE; DS5160/MG996R have no pocket-clearance constant of their own). MG996R pocket uses 0.25 mm per side across the body width.
- Hip interface: SCS15/SC15 round horn screw pattern ASSUMED 4x M3 on 14.0 mm PCD with 10.0 mm center hub clearance -- only SCS15_ROUND_HORN_DIA (19.95) is researched. MEASURE the shipped horn before printing.
- Knee horn: DS5160 round horn ASSUMED 4x M3 on 17.0 mm PCD with 10.0 mm center clearance; horn stack height taken from DS5160_OVERALL_HEIGHT_WITH_HORN (56.8, itself flagged UNVERIFIED in hardware_constants). MEASURE the shipped horn.
- Idler pivot (a documented design call; the brief allowed M3 or a bearing): M3 x 12 screw + washer, self-tapped into a 2.7 mm pilot through the thigh web + a 12 mm dia boss (7.5 mm engagement, boss top 0.5 mm below the servo body); calf inboard lug gets an M3_CLEAR (3.4) hole; 0.5 mm running washer gap is built into the clevis span. Upgrade path: bore the lug to 8.0 and press a 693ZZ bearing.
- Gravity posts: 6 dia x 8 long with a 4.4 dia x 1.6 retention groove. Thigh posts are horizontal in print orientation and carry a full-length 45-deg under-wedge (the allowed chamfer/under-cone); calf posts are vertical with a 45-deg under-cone below the tip flange. Post positions: thigh x=18/28 near hip on the front wall; calf x=55/104.5 on the front face over the ankle flange blocks.
- MG996R ankle mount: M3 self-tappers into 2.7 mm pilots at the nominal 48.3 x 10.2 hole centers; flange bears flat on the outboard face (no recess). Constants are flagged clone-variant -- caliper the shipped servo.
- Architectural dims (module constants, sweepable): web and walls 4.0 mm (>= WALL_MM 3.0), hip disc dia 34 x 6 thick, knee-end outline radius 26 concentric with the knee axis giving a constant 3 mm crossbar running gap and roughly +/-85 deg knee ROM from straight, 4 mm air gap under the DS5160 body, calf depth 30, calf beam width 34, clevis lug thickness 5, DS5160 pilot columns lightened by 9 mm wide full-height notches (the rear one doubles as the servo wire drop-in channel).
- Handedness: the exported pair is ONE leg; print the mirror-image set (slicer mirror) for the other leg, as noted in the docstring.

### Verification measurements
- Re-run: exports regenerate deterministically — thigh_link.stl md5 f8b7c9b0..., calf_link.stl md5 0609df10... identical before/after; STEP twins present; script output matches claims exactly
- Bounding boxes vs 350 mm bed: thigh 133.00 x 53.80 x 39.00 mm (91.3 cm^3), calf 129.00 x 75.30 x 38.00 mm (55.9 cm^3), both z-min = 0 (print orientation, bed at Z=0)
- Walls (probe-measured, rule >= 3.0): thigh web 4.000, thigh side walls 4.000/4.000 (x=10), knee-block walls 5.350 (cavity start) and 8.500 (x=70), hip plate 6.000; calf web 4.000, MG floor strip 4.750, -Y beam wall 4.000, clevis lugs 5.000 each (10.000 total at x=-9), crossbar 4.000
- DS5160 pocket: cavity faces at x=37.30/103.30 -> length 66.00 = body 65.0 + 0.5/side; width 31.00 = body 30.0 + 0.5/side; tab ledge height 39.00 = web 4 + gap 4 + TAB_UNDERSIDE 31.0; pilot pattern 75.0 x 17.0 exact; pilots 12.0 deep (material stops at z=27.00); M4 pilot 3.6 = 0.9*d house rule
- MG996R pocket: cavity faces at x=59.20/100.50 -> 41.30 = body 40.3 + 0.5/side; floor at z=4.75 -> 0.25 body-width clearance; flange seat: body bottom -9.7 vs floor -10.2 -> 0.5 clearance; pilot pattern 48.30 x 10.20 exact, blind bores y 8.5..18 (8.5 mm engagement, 0.5 mm shy of through)
- Knee axis both-sides support: clevis inner span 65.30 = DS horn top 64.80 (8.0 + OVERALL_HEIGHT_WITH_HORN 56.8) + 0.5 washer gap; lug faces at +/-32.65 and +/-37.65 confirmed; idler boss top z=7.5 with 0.5 mm air to DS body bottom z=8.0; M3 pilot (2.7) through web+boss = 7.5 mm engagement; all horn/idler/teardrop voids probe-confirmed present
- Ligaments (probe-measured): hip disc center-bore -> M3 hole 0.303 mm (x4); thigh M4 pilot -> notch 2.208 mm, -> cavity 2.608/2.808 mm; calf MG pilot -> cavity 2.020/2.320 mm; calf knee-horn hole -> hub-clear 1.80 mm (analytic, on the 5 mm lug)
- Overhang audit (>50 deg from vertical, off-bed, facet-normal integration): thigh 63.9 mm^2 total (6 clusters, all at the 2 horizontal posts, largest 20.2 mm^2); calf 198.6 mm^2 total (11 clusters: lug bed-tangent bands 37.4 mm^2 x2 at max 77 deg, hole ceilings 11.9-16.2 mm^2 x9 at 90 deg); largest single cluster 0.37 cm^2 -> nothing exceeds the 2 cm^2 needs-supports bar; 44-50 deg context bands: 144.5 / 122.8 mm^2 (the 45-deg wedges and teardrop roofs land here, as designed)
- Mesh integrity: calf 0 non-manifold edges of 13746; thigh 4 non-manifold (4-facet) edges of 14588 — all at the wedge/post tangency lines z=11.0 at posts x=18/28, a tangent-seam artifact, not a defect
- Architecture: hip->knee 90.0 and knee->ankle 90.0 as required (module constants); hip disc 34.0 dia covers the 19.95 SCS15 horn; crossbar gap CB_X0 29 = KNEE_TIP_R 26 + 3.0 running clearance; calf posts anchored on solid columns 0..38 (z-scan voids at z~9-11/19-21.5 are the expected cross-drilled MG pilot bores 10+ mm below the post bases); post spec 6.0 dia x 8.0 with 4.4 x 1.6 groove on both links; SPINE_ROD_SPACING_MM 120.0 not applicable (no spine features in leg parts)

## Post-verification fixes applied
- waist_box.py: ST3215 boss retention holes 2.4 mm -> M3_CLEAR (3.4 mm). The boss holes are
  M3-class (ST3215_TOP_HOLE_DIA=2.5 tap, ST3215_HORN_SCREW_M=3); as authored the waist-yaw
  servo could not be screwed down. Regenerated + asserts pass. FIXED.

## Open design decisions (awaiting the author's decision)
1. Chest/waist telescope geometry contradiction: chest BOX_DEPTH=130 > waist interior depth 114,
   and the chest rod line is at its rear while waist shafts are centered — the chest cannot
   descend into the waist mouth as the waist docstring assumes. Options: (a) accept chest riding
   above the rim (works today, loses nested stroke), (b) shrink chest depth <= ~108 and move its
   rod towers to mid-depth, (c) deepen the waist. One shared INTERFACE constants block should pin this.
2. Hip DOF plan: waist authoring gave each leg two PARALLEL pitch-type SCS15 axes (roll deferred to
   an unbuilt bracket) and moved bays to the FRONT corners (rear is geometrically impossible against
   the battery bay). Sign off or redesign before printing the waist.
3. MG996R mounts (chest shoulders + calf ankle) use fixed round pilots at nominal spacing despite the
   constants recommending slotted holes for clone variance — decide after calipering the actual servos.
