Eliezer-Davidson/alpha-centauri/cad/alpha_centauri/foot.py

"""Alpha Centauri — foot: PETG core + SEPARATE TPU tread. Four identical pairs.

    edu/.cadenv/bin/python cad/alpha_centauri/foot.py

THE CONTRACT THIS PART EXISTS TO KEEP
-------------------------------------
The foot presents a SPHERE of radius FOOT_SPHERE_R = 15 whose centre sits ON
the calf axis at FOOT_CENTRE_FROM_KNEE = L3 - R from the knee. The OUTER
surface of the TPU tread IS that sphere. Not "about", not "plus a pad": if the
tread added thickness outside R15 the contact point would drop below the IK's
ground plane and silently change the stance -- the same class of bug (sphere
centred AT the foot instead of ON the axis) already put the drawn robot at the
forbidden 250 mm stance once. So:

    PETG core outer radius = R15 - TREAD_T   (12.0, ground side)
    TPU tread outer radius = exactly R15, SAME centre

and the build asserts both on the finished solids: every tread vertex sits in
the 12..15 shell with the outer surface exactly at 15 (the one deliberate
exception, the retention bead, is confined and asserted -- see RETENTION
below), every core vertex on the ground side of the centre sits inside 12,
and the assembled contact radius stays 15.000 at every tilt in the swept
swing check below.

WHY THE TREAD IS A FULL HEMISPHERE ENDING ON THE COLLAR RIM
-----------------------------------------------------------
Required angular coverage is DERIVED, not guessed: the calf tilts up to
~37.9 deg from vertical across the working envelope (the ~38.5 deg swing the
constants comment records -- reproduced here from the leg geometry, see
calf_tilt_deg), plus the angular half-width of the squished contact patch,
plus margin -- about 54 deg. A cap of exactly that size was drawn first and
rejected for its EDGE: any free-floating tread edge is either a >45 deg
overhung ring (radial cut), a knife-edge TPU taper (chamfered cut), or a ring
bridging over air (horizontal cut). Making the clamp collar diameter EQUAL to
the sphere (COLLAR_D = 2*R15 = 30) dissolves the problem: the tread runs all
the way to the equator and its termination ring lands flat ON the collar's
own rim, supported by PETG, with zero overhang. The silhouette is a cylinder
blending into its own ball, and coverage is 90 deg against the ~54 needed.

The PETG collar rim circle lies exactly ON the R15 sphere at the equator --
which is fine, and checked: at the maximum swept tilt it still clears the
ground (gate 4 measures the number), and the sweep assert below keeps it
that way forever.

SPLIT FOR THE A1 MINI (2026-09-07, REPLAN-2026-08-28 items 1 & 5)
-----------------------------------------------------------------
This file originally CO-PRINTED the two bodies -- TPU deposited onto the PETG
dome mid-print by the H2C's second nozzle. The H2C is gone; the only printer
is a Bambu A1 mini with ONE nozzle, so the co-print object no longer exists
on any machine this project owns. The tread is now a SEPARATE TPU part that
snaps onto the finished core. Everything the co-print design got right (the
contract, the hemisphere-to-rim termination, the clamp) is unchanged;
what is new is mechanical retention plus an assembly law:

    ASSEMBLY LAW: the tread is retained by the circumferential bead/groove
    engagement below AND a flexible adhesive of the Shoe-Goo class wetting
    the 905 mm2 spherical interface + 254 mm2 rim ring. NEVER glue alone --
    an adhesive-only joint on a flexing TPU shell fails by peel at the rim,
    exactly the load the bead exists to anchor. (Wet assembly is also the
    lubricant that makes the snap easy.)

RETENTION -- INTERNAL BEAD INTO A DOME GROOVE (the DECISION)
------------------------------------------------------------
The tread carries an internal circumferential BEAD: a spherical-band ridge
BEAD_H = 0.8 mm proud of its R12 bore, spanning polar angle 58..73 deg from
the ground pole. The core's dome carries the matching circumferential GROOVE,
cut 57..74 deg (1 deg polar play per side, ~0.2 mm) with its floor at
R11.0 -- 0.2 mm BELOW the bead crest, deliberately: the tread's radial seat
must always be the R12 dome-on-bore contact, never the bead bottoming in a
shallow groove, because a bead that props the shell outward moves the outer
surface past R15 and silently violates the contract. The groove is cut
deeper than the bead can reach; adhesive fills the void.

Rejected alternatives, recorded so they are not redrawn:
  * TPU skirt over the collar with a bead into a collar-OD groove: any skirt
    material below the equator and outside the collar sits OUTSIDE the R15
    sphere -- it fails the contract's own vertex gate. The gate is right and
    the skirt is wrong: material out there widens the presented ball.
  * Spherical undercut at the equator (expose the R12 ball below its equator
    and let the shell wrap past it): the exposed neck necks down below
    R12.0, but the socket's box-pocket corner sweeps a 12.42 mm radius --
    the undercut breaches into the pocket. Negative wall, dead on arrival.
The chosen band sits entirely ABOVE the equator (groove floor ends 3.0 mm
above it -- clear of collar and socket by construction, asserted) and
entirely OUTSIDE the derived contact envelope (band starts at 58 deg against
the ~55 deg the envelope needs, asserted): no contact pose ever loads the
one ring where tread backing thickness differs, so contact compliance is
uniform over every reachable touchdown.

Mechanics, derived in-code and asserted: snap-on travel is ~1.4 mm with a
peak bead hoop strain of BEAD_H/BEAD_R_IN = 7.1% -- trivial for TPU 95A
(elongation at break ~450%). Pull-off is blocked by the groove's pole-side
shoulder after ~0.23 mm of polar play: gate 6 MOVES the tread 1.0 mm along
the pull-off axis and asserts real solid interference with the core, so the
retention is proven on the geometry, not asserted in prose. Spin about the
calf axis is the one motion the bead does not resist -- it is geometrically
harmless (the tread is a body of revolution; the contact sphere is invariant)
and the adhesive owns it.

HOW IT CLAMPS THE CALF -- AND WHY A THROUGH-BOLT, NOT A PINCH
-------------------------------------------------------------
The calf ends in a 16 mm x 14 mm boss -- but the boss and the calf's 20 x 14
box shaft END TOGETHER at the sphere centre, so the socket must swallow both:
the pocket is the union of the box section and the boss bore, cut SOCKET_CLEAR
loose. That is a feature, not a workaround: the box flats are anti-rotation
for free, and the boss end face bottoming on the pocket floor puts the sphere
centre at FOOT_CENTRE_FROM_KNEE by construction -- zero axial adjustment.
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
